eSpark-Consulting-Group/stephenlong-poddesign-hw/Design-Files/POD-Design-v1.1/Deliverables/BOM/Client_BOM_POD-Design-v1.1.xlsx

# | Item Type | Designator | Description | Footprint | Manufacturer Part Number | Manufacturer | Value | Quantity | Remarks
1 | Antenna | ANT1 | RF ANT 2.4GHZ CHIP SOLDER SMD | ANT-1206 | 2450AT18B100E | Johanson | - | 1
2 | Diodes | BR3 | BRIDGE RECT 1P 600V 1A 4MICRODIP | TSSOP-4(5.0x4.4) | MDB6S | ON Semiconductor / Fairchild | - | 1
3 | Capacitors | C1, C2, C3, C4, C5, C6, C7, C8, C11, C12, C13, C14 | CAP CER 0.022UF 50V C0G/NP0 0805 | Cap-0805 | GRM21B5C1H223JA01L | Murata | 22nF | 12
4 | Capacitor | C9, C10 | CAP CER 15PF 50V C0G/NPO 0603 | Cap-0603 | CC0603JRNPO9BN150 | Yageo | 15pF | 2
5 | Capacitors | C15, C16, C17, C18, C20, C22, C24, C110, C111 | CAP CER 0.1UF 50V X7R 0603 | Cap-0603 | GCJ188R71H104KA12D | Murata | 0.1uF | 9
6 | Capacitors | C19, C21, C23, C25 | CAP CER 4.7UF 10V X7R 0603 | Cap-0603 | GRM188Z71A475KE15D | Murata | 4.7uF | 4
7 | Capacitors | C26, C29, C32 | 51 pF ±1% 250V Ceramic Capacitor C0G, NP0 0603 (1608 Metric) | Cap-0603 | GQM1875C2E510FB12D | Murata | 51pF | 3
8 | Capacitors | C27, C28, C30, C31, C33, C34 | CAP CER 0.022UF 500V X7R 1206 | Cap-1206 | CC1206KKX7RBBB223 | Yageo | 22nF | 6
9 | Capacitor | C35, C38 | CAP CER 1UF 16V X5R 0402 | Cap-0402 | CC0402KRX5R7BB105 | Yageo | 1uF | 2
10 | Capacitor | C36 | CAP CER 0.047UF 50V X7R 0402 | Cap-0402 | CC0402KRX7R9BB473 | Yageo | 47nF | 1
11 | Capacitors | ~~C37, C44~~ | ~~CAP CER 0.1UF 16V X7R 0402~~ | ~~Cap-0402~~ | ~~CC0402KRX7R7BB104~~ | ~~Yageo~~ | ~~DNP~~ | ~~2~~ | ~~DO NOT PLACE~~
12 | Capacitors | C39, C43, C52, C53, C55, C60, C67, C69, C71 | CAP CER 0.1UF 16V X7R 0402 | Cap-0402 | CC0402KRX7R7BB104 | Yageo | 0.1uF | 9
13 | Capacitor | C40, C41 | CAP CER 6.8PF 50V C0G/NPO 0402 | Cap-0402 | CC0402CRNPO9BN6R8 | Yageo | 6.8pF | 2
14 | Capacitor | C42 | CAP CER 100PF 50V C0G/NPO 0402 | Cap-0402 | CC0402JRNPO9BN101 | Yageo | 100pF | 1
15 | Capacitor | C45 | CAP CER 2.2PF 50V C0G/NP0 0402 | Cap-0402 | GRM1555C1H2R2BA01D | Murata | 2.2pF | 1
16 | Capacitor | C46, C47 | 50V 9pF C0G 0402 Multilayer Ceramic Capacitors MLCC - SMD/SMT ROHS | Cap-0402 | 0402CG9R0C500NT | FH (Guangdong Fenghua Advanced Tech) | 9pF | 2
17 | Capacitor | C48 | CAP CER 0.8PF 50V C0G/NPO 0402 | Cap-0402 | CC0402BRNPO9BNR80 | Yageo | 0.8pF | 1
18 | Capacitor | C49 | CAP CER 820PF 50V C0G/NPO 0603 | Cap-0603 | CC0603JRNPO9BN821 | Yageo | 820pF | 1
19 | Capacitor | C50, C51, C54 | CAP CER 4.7UF 16V X5R 0402 | Cap-0402 | CL05A475MO5NUNC | Samsung | 4.7uF | 3
20 | Capacitor | C56 | CAP ALUM POLY 120UF 20% 20V SMD | Custom | 20SVPF120M | Panasonic | 120uF | 1
21 | Capacitor | C57, C58, C59, C61, C62, C70, C73 | CAP CER 10UF 10V X7R 0603 | Cap-0603 | GRM188Z71A106KA73D | Murata | 10uF | 7
22 | Capacitor | C63, C68 | CAP CER 0.1UF 16V X7R 0402 | Cap-0402 | CC0402JRX7R7BB104 | Yageo | 0.1uF | 2
23 | Capacitor | C64, C65 | CAP CER 22UF 10V X7R 0805 | Cap-0805 | GRM21BZ71A226ME15L | Murata | 22uF | 2
24 | Capacitors | C66 | CAP CER 1UF 6.3V X7R 0402 | Cap-0402 | GRM155R70J105KA12J | Murata | 1uF | 1
25 | Capacitor | C72 | 10uF 160V ±20% SMD,D8xL10.2mm Aluminum Electrolytic Capacitors - SMD ROHS | Custom | UD2C100M0810 | Honor Elec | 10uF | 1
26 | Capacitors | C74 | CAP CER 0.1UF 50V X7R 0603 | Cap-0603 | CC0603JRX7R9BB104 | Yageo | 0.1uF | 1
27 | Capacitor | C75, C77 | 50V 6.8nF X7R ±10% 0603 | Cap-0603 | 0603B682K500NT | FH | 6.8nF | 2
28 | Capacitor | C76 | CAP CER 0.015UF 50V X7R 0603 | Cap-0603 | CC0603JRX7R9BB153 | Yageo | 15nF | 1
29 | Capacitor | C78, C79 | CAP CER 1000PF 25V X7R 0402 | Cap-0402 | CC0402KRX7R8BB102 | Yageo | 1nF | 2
30 | Capacitor | C98 | CAP CER 1000PF 25V X7R 0603 | Cap-0603 |  |  | 1000pF | 1
31 | Capacitor | C99 | CAP CER 2200PF 50V X7R 0603 | Cap-0603 | CC0603KRX7R9BB222 | Yageo | 2.2nF | 1
32 | Capacitors | C100 | CAP CER 0.033UF 50V X7R 0603 | Cap-0603 | GCJ188R71H333KA12D | Murata | 33nF | 1
33 | Capacitor | C101 | CAP CER 0.1UF 50V X7R 0402 | cap-0402 | C1005X7R1H104KT000F | TDK | 100nF | 1
34 | Capacitors | C102 | CAP CER 0.033UF 25V X7R 0603 | Cap-0603 | CC0603JRX7R8BB333 | Yageo | 33nF | 1
35 | Capacitors | C103 | CAP CER 1UF 25V X7R 0603 | Cap-0603 | C1608X7R1E105K080AB | TDK | 1uF | 1
36 | Capacitors | C104 | CAP CER 2.2UF 50V X7R 0805 | Cap-0805 | CC0805KKX7R9BB225 | Yageo | 2.2uF | 1
37 | Diodes | D1, D2, D3, D4, D5, D6 | DIODE ARR GP 100V 215MA TO-236AB | SOT-23 | BAV99,215 | Nexperia | - | 6
38 | Diode | D7 | DIODE ZENER 3.3V 200MW SOD323F | SOD323F | MM3Z3V3B | ON Semiconductor / Fairchild | - | 1
39 | TVS Diodes | D8 | TVS DIODE 3VWM SOT323-5 | SOT-323-5 | ESDALC6V1W5 | STMicroelectronics | - | 1
40 | Diodes | D11, D16, D17, D18 | DIODE AVAL 600V 1.5A DO214AC | SMA(DO-214AC) | BYG20J-E3/TR | Vishay Semiconductors | - | 4
41 | Diode | D19 | Independent Type 2.5V~2.9V 500mW 2.7V LL-34 Zener Diodes ROHS | LL-34 | ZMM2V7 | HXY MOSFET | - | 1
42 | Ferrite Beads | FB1, FB2, FB3, FB4 | FERRITE BEAD 1.5 KOHM 0805 1LN | Ind-0805 | BLM21BD152SN1D | Murata | - | 4
43 | Ferrite Beads | FB5 | FERRITE BEAD 220 OHM 0805 1LN | Ind-0805 | BLM21PG221SN1D | Murata | - | 1
44 | Ferrite Bead | FB6 | FERRITE BEAD 1K OHM 0805 1LN | Ind-0805 | MMZ2012R102ATD25 | TDK | - | 1
45 | Ferrite Beads | FB7, FB8 | FERRITE BEAD 1 KOHM 0603 1LN | IND-0603 (1608 Metric) | BLM18HE102SN1D | Murata | - | 2
46 | USB Connector | J1 | 5A 1 16P Female Type-C SMD USB Connectors ROHS | Custom | TYPE-C-31-M-12 | Korean Hroparts Elec | - | 1
47 | Terminal Block | J2 | 320V 20A 14 Bend -40℃~+105℃ 1 5.08mm 1x14P Green Receptacle-Close Screw Fixing Push-Pull,P=5.08mm Pluggable System Terminal Block ROHS | Custom | DB2ERM-5.08-14P-GN | DORABO | - | 1
48 | Terminal Block | J3 | -40℃~+105℃ 2.5 1 14~28 5.08mm 320V 20A 14 1x14P Green Plug Screw Fixing P=5.08mm Pluggable System Terminal Block ROHS | Custom | DB2EKM-5.08-14P-GN-S | DORABO | - | 1
49 | Tag Connect | J4 | CABLE ADAPTER 6 POS | Custom | TC2030-IDC | Tag-Connect | - | 1
50 | Terminal Block | J5 | 320V 20A 4 Bend -40℃~+105℃ 1 5.08mm 1x4P Green Receptacle-Close Screw Fixing Push-Pull,P=5.08mm Pluggable System Terminal Block ROHS | Custom | DB2ERM-5.08-4P-GN | DORABO | - | 1
51 | Terminal Block | J6 | -40℃~+105℃ 2.5 1 14~28 5.08mm 320V 20A 4 1x4P Green Plug Screw Fixing P=5.08mm Pluggable System Terminal Block ROHS | Custom | DB2EKM-5.08-4P-GN-S | DORABO | - | 1
52 | Terminal Block | J7 | 1000V 57A 1 1 10.16mm P=10.16mm Pluggable System Terminal Block ROHS | Custom | DB136H-10.16-1P-RD-P | DORABO | - | 1
53 | Terminal Block | J8 | 1000V 57A 1 1 10.16mm P=10.16mm Pluggable System Terminal Block ROHS | Custom | DB136H-10.16-1P-BK-P | DORABO | - | 1
54 | Inductor | L1 | FIXED IND 15NH 400MA 0.45OHM SMD | IND-0402 | LQG15HN15NJ02D | Murata | 15nH | 1
55 | Inductors | L2 | FIXED IND 10UH 250MA 1.05OHM SMD | IND-0603 (1608 Metric) | MLZ1608M100WT000 | TDK | 10uH | 1
56 | Inductors | L3, L4 | FIXED IND 3.9NH 350MA 350MOHM SM | IND-0201 | LQP03TG3N9B02D | Murata | 3.9nH | 2
57 | Inductor | ~~L5~~ | ~~FIXED IND 2.7NH 500MA 200MOHM SM~~ | ~~IND-0201~~ | ~~LQP03TN2N7B02D~~ | ~~Murata~~ | ~~DNP~~ | ~~1~~ | ~~DO NOT PLACE~~
58 | Inductor | L6 | 2.34A 1.5uH Shielded Power Inductors ±20% SMD Power Inductors ROHS | Custom | LVT303012-1R5M-N | Chilisin Elec | 1.5uH | 1
59 | Inductor | L7 | 4A 2.2uH ±20% 32mΩ SMD,5.4x5.2x2mm Power Inductors ROHS | Custom | YSPI0520-2R2M | YJYCOIN | 2.2uH | 1
60 | LED | LED1, LED2, LED3, LED4, LED5 | Emerald 0603 Light Emitting Diodes (LED) ROHS | LED-0603 | NCD0603G2 | Foshan NationStar Optoelectronics | - | 5
61 | LED | LED6, LED7 | RED LED 0603 Light Emitting Diodes | LED-0603 | NCD0603R3 | Foshan NationStar Optoelectronics | - | 2
62 | Transistor | Q1 | TRANS NPN 40V 0.2A SOT523 | SOT-523 | MMBT3904T-7-F | Diodes Zetex | - | 1
63 | Triac | Q2 | 10mA 600V 1 TRIAC SOT-23-3L Thyristors (SCR)/Modules ROHS | SOT-23 | MAC97A6-23-3L | KY | - | 1
64 | SCRs | Q5, Q8 | SCR 800V 1.25A SOT223 | SOT- 223 | X0202NN 5BA4 | STMicroelectronics | - | 2
65 | BJTs | Q6 | TRANS NPN 400V 8A D2PAK | D2PAK | STB13007DT4 | STMicroelectronics | - | 1
66 | Resistor | R1, R5, R7, R8, R9, R13, R15, R19, R24, R25 | RES SMD 0R, 1%, 0.1W, 0603 | Res-0603 | RC0603FR-070RL | Yageo | 0R | 10
67 | Resistor | R2, R6, R10, R14, R16, R20 | RES SMD 1K OHM 1% 1/10W 0603 | Res-0603 | RC0603FR-071KL | Yageo | 1K | 6
68 | Resistors | R3, R4, R11, R12, R17, R18 | RES 0.002 OHM 1% 3W 2512 | RES-2512 | PA2512FKE7T0R002E | Yageo | 2mR | 6
69 | Resistor | R21, R22, R65, R66, R142, R143, R147 | RES 4.7K OHM 1% 1/16W 0402 | Res-0402 | RC0402FR-074K7L | Yageo | 4.7K | 7
70 | Resistor | R23 | RES SMD 10K Ohm 1% 1/10W 0603 | Res-0603 | RC0603FR-0710KL | Yageo | 10K | 1
71 | Resistor | R26, R27, R28, R29 | RES SMD 680 OHM 1% 1/10W 0603 | Res-0603 | RC0603FR-07680RL | Yageo | 680R | 4
72 | Resistors | R30, R31, R32, R33, R36, R37, R38, R39, R42, R43, R44, R45 | RES SMD 200K OHM 1% 1W 2512 | RES-2512 | CRCW2512200KFKEG | Vishay Dale | 200K | 12
73 | Resistor | R34, R35, R40, R41, R46, R47, R74 | RES 1K OHM 5% 1W 2512 | RES-2512 | RC2512JK-071KL | Yageo | 1K | 7
74 | Resistors | R48, R49, R50, R51, R52, R53, R54, R55, R56, R57, R58, R59, R60, R61, R62, R63, R64, R91, R92, R95, R152, R166, R167, R168, R169 | RES 0 OHM JUMPER 1/16W 0402 | Res-0402 | RC0402FR-070RL | Yageo | 0R | 25
75 | Resistor | R67, R76, R77, R78, R79, R80, R81, R82, R83, R89, R90, R157, R175 | RES 10K OHM 1% 1/16W 0402 | Res-0402 | RC0402FR-0710KL | Yageo | 10K | 13
76 | Resistor | R68 | RES 3.3K OHM 1% 1/16W 0402 | Res-0402 | RC0402FR-073K3L | Yageo | 3.3K | 1
77 | Resistor | R69, R73 | RES 1K OHM 1% 1/16W 0402 | Res-0402 | RC0402FR-071KL | Yageo | 1K | 2
78 | Resistor | ~~R70~~ | ~~RES SMD 100K OHM 0.1% 1/16W 0402~~ | ~~Res-0402~~ | ~~RT0402BRD07100KL~~ | ~~Yageo~~ | ~~DNP~~ | ~~1~~ | ~~DO NOT PLACE~~
79 | Resistor | R71, R72 | RES 5.1K OHM 1% 1/16W 0402 | Res-0402 | RC0402FR-075K1L | Yageo | 5.1K | 2
80 | Resistor | R75 | RES 680 OHM 1% 1/16W 0402 | Res-0402 | RC0402FR-07680RL | Yageo | 680R | 1
81 | Resistor | R84, R87, R134, R138 | RES 0 OHM JUMPER 1/8W 0805 | Res-0805 | RC0805FR-070RL | Yageo | 0R | 4
82 | Resistor | R85 | 3W ±1% 200kΩ 2512 Chip Resistor - Surface Mount ROHS | RES-2512 | HoCUH2512-3W-200KR-1% | Milliohm | 200K | 1
83 | Resistors | R86 | RES 6.2K OHM 5% 2W 2512 | RES-2512 | RC2512JK-7W6K2L | Yageo | 6.2K | 1
84 | Resistor | R88 | RES SMD 220 OHM 1% 1/10W 0603 | Res-0603 | RC0603FR-07220RL | Yageo | 220R | 1
85 | Resistor | R98, R161 | RES SMD 4.7K OHM 1% 1/10W 0603 | Res-0603 | RC0603FR-074K7L | Yageo | 4.7K | 2
86 | Resistors | R99, R100, R101 | RES 330 OHM 1% 1/4W 1206 | Res-1206 | RC1206FR-07330RL | Yageo | 330R | 3
87 | Resistor | R102, R144 | RES 0 OHM JUMPER 1W 2512 | RES-2512 | RC2512JK-070RL | Yageo | 0R | 2
88 | Resistor | R103, R104, R139, R140, R145, R146 | 1W Thick Film Resistor 200V ±100ppm/℃ ±1% 10kΩ 2512 Chip Resistor - Surface Mount ROHS | RES-2512 | FRC2512F1002TS | FOJAN | 10K | 6
89 | Resistor | ~~R132, R133, R135~~ | ~~RES 0 OHM JUMPER 1/8W 0805~~ | ~~Res-0805~~ | ~~RC0805FR-070RL~~ | ~~Yageo~~ | ~~DNP~~ | ~~3~~ | ~~DO NOT PLACE~~
90 | Resistor | R136 | 333mW Thin Film Resistor 200V ±0.5% ±10ppm/℃ 31.6kΩ 1206 Chip Resistor - Surface Mount ROHS | Res-1206 | TC0610D3162T5K | Uniroyal | 31.6K | 1
91 | Resistors | R137 | RES SMD 243 OHM 1% 1/4W 1206 | Res-1206 | AC1206FR-07243RL | Yageo Group | 243R | 1
92 | Resistor | R141, R173 | RES 3.3K OHM 0.5% 1/10W 0603 | Res-0603 | RC0603DR-073K3L | Yageo | 3.3K | 2
93 | Resistor | R148 | 1.5W Thick Film Resistors 400V ±100ppm/℃ ±5% 1MΩ 2010 Chip Resistor - Surface Mount ROHS | RES-2010 | AS101AJ0105T4E | UNI-ROYAL(Uniroyal Elec) | 1M | 1
94 | Resistor | R150 | RES 10K OHM 1% 1/10W 0603 | Res-0603 | RK73G1JTTD1002F | KOA Speer | 10K | 1
95 | Resistors | R158, R170, R171, R172 | RES 49.9K OHM 1% 1/4W 1206 | Res-1206 | RC1206FR-0749K9L | Yageo Group | 49.9K | 4
96 | Resistor | R162, R163, R164, R165 | RES 0 OHM JUMPER 1/10W 0603 | Res-0603 | RC0603JR-070RL | Yageo | 0R | 4
97 | Resistor | R174 | RES SMD 1K OHM 1% 1/10W 0603 | Res-0603 | CRCW06031K00FKEA | Vishay Dale | 1K | 1
98 | Resistors | R176, R178 | RES SMD 220K OHM 0.1% 1/4W 1206 | Res-1206 | RT1206BRD07220KL | Yageo | 220K | 2
99 | Resistor | R177 | 250mW Thick Film Resistors 200V ±100ppm/℃ ±1% 330Ω 1206 Chip Resistor - Surface Mount ROHS | Res-1206 | FRC1206F3300TS | FOJAN | 330R | 1
100 | Varistors | RV3 | 775V 385V 300V 470V Plugin Varistors ROHS | Custom | 471KD10J | Yageo | - | 1
101 | IC | U1 | IC AFE 7 CHAN 40LFCSP-WQ | 40-LFCSP-WQ (6x6) | ADE9000ACPZ | Analog Devices | - | 1
102 | IC | U2 | DGTL ISO 5000VRMS 4CH GP 16SOIC | SOIC-16-300mil | ISO7741DWR | Texas Instruments | - | 1
103 | IC | U3 | IC RF TXRX+MCU 802.15.4 73QFN | AQFN-73-EP(7x7) | NRF52840-QIAA-R | Nordic Semiconductor | - | 1
104 | IC | U4 | IC FLASH 128MBIT SPI/QUAD 8WSON | WSON-8-EP(6x8) | W25Q128JVEIQ | Winbond | - | 1
105 | IC | U5 | 1.6-V TO 5.5-V, 20-M, 4-A LOW IQ | SOT-583 | TPS2117DRLR | Texas Instruments | - | 1
106 | IC | U6 | IC REG BUCK BST 3.3V 900MA 10SON | 10-SON (2.5x2.5) | TPS63031DSKR | Texas Instruments | - | 1
107 | Power Module | U7 | Plugin Isolated Power Modules ROHS | Custom | B0303S-1WR2 | YLPTEC | - | 1
108 | (TVS/ESD) | U8 | 6A 12V 150W 6V Unidirectional 5V SOT-23-6 ESD and Surge Protection (TVS/ESD) ROHS | SOT-23-6 | USBLC6-2SC6 | TECH PUBLIC | - | 1
109 | IC | U9 | 4V~6V Polymer 1 3.5A SOP-8-EP Battery Management ICs ROHS | 8-SO-EP_ | SLM6600 | SOLA-IC | - | 1
110 | IC | U10 | IC BATT MON LI-ION 1CELL 8TDFN | 8-TDFN-EP (2x2) | MAX17048G+T10 | Maxim | - | 1
111 | IC | U11 | SHTC3 Series Digital ±2% RH SMT Humidity Temperature Sensor - DFN-8 | 4-WDFN Exposed Pad | SHTC3-TR-2.5KS | Sensirion | - | 1
112 | Accelerometers | U12 | ACCEL 2-16G I2C/SPI 14LGA | 14-LGA (3x5) | ADXL345BCCZ-RL7 | Analog Devices | - | 1
113 | IC | U13 | IC ADC 16BIT SIGMA-DELTA 10VSSOP | VSSOP-10 | ADS1115IDGSR | Texas Instruments | - | 1
114 | Current Sensors | U14 | POSITION&CURRENT SENSORS | TISON-8(8x8) | TLI4971-A120T5-U-E0001 | Infineon | - | 1
115 | IC | U15 | OPTOISOLATOR 4.17KV TRIAC 6SMD | SMD-6P | MOC3083SR2M | ON Semiconductor / Fairchild | - | 1
116 | Sensor and Detector Interfaces | U17 | IC SIGNAL PROCESSOR 14TSSOP | 14-TSSOP | NCS37020DTBR2G | onsemi | - | 1
117 | IC | U18 | DGTL ISO 5000VRMS 4CH GP 16SOIC | SOIC-16-300mil | ISO7740DWR | Texas Instruments | - | 1
118 | IC | U19, U20 | OPTOISOLATOR 5.3KV TRANS 4SMD | Custom | SFH6156-2 | Vishay | - | 2
119 | Crystal | X1 | 24.576MHz Surface Mount Crystal 12pF ±10ppm ±20ppm SMD3225-4P Crystals ROHS | SMD3225-4P | X322524576MOB4SI | YXC | 24.576MHz | 1
120 | Crystal | X2 | Crystal, 32.768KHZ, 6PF, 3.2MM X 1.5MM Rohs Compliant: Yes | SMD3215-2P | Q13FC13500049 | Epson | 32.768KHz | 1
121 | Crystal | X3 | CRYSTAL 32.0000MHZ 8PF SMD | SMD2016-4P | Q22FA12800025 | Epson | 32MHz | 1
