eSpark-Consulting-Group/stephenlong-poddesign-hw/Design-Files/POD-Design-v1.1/Deliverables/Supporting Files/POD-Design-v1.1.step

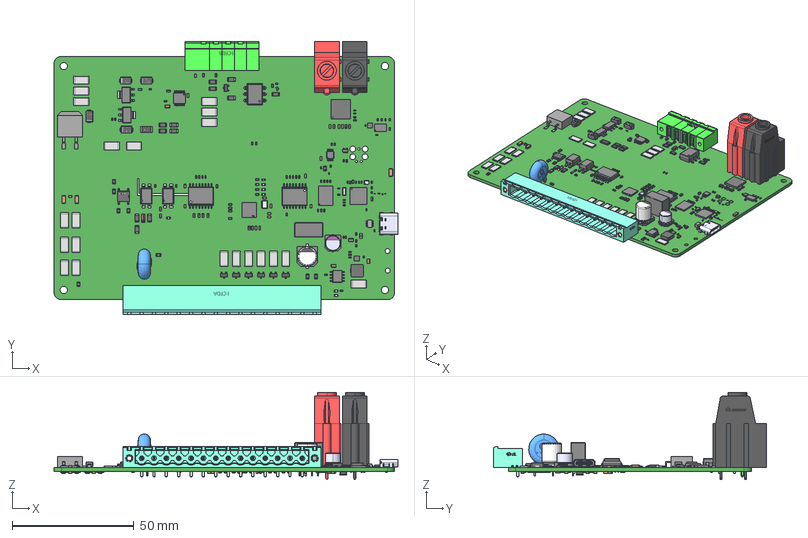
[picture p1: CAD file, 2025-09-22]
Design-Files/POD-Design-v1.1/Deliverables/Supporting Files/POD-Design-v1.1.step
141.4 x 112.3 x 35.8 mm
CircuitWorks-RESISTOR 2512 x 35
ISO1050DWR x 2
User Library-CR3216-1206 x 12
User Library-RES_1005-0402 x 52
User Library-RESC1608X05N x 32
User Library-LED SMD0603 x 7
Lötende x 6
base x 3
SMA (DO-214AC) x 4
User Library-CAPC1608X09 x 35
User Library-1206 SMD Capacitor x 7
User Library-SOT-223-1 x 2
TXB0104PWR
User Library-R_2010
User Library-CR2012-0805 x 7
pwr263s-35-8r20f_RGB6710886
CircuitWorks-SOT-23 x 7
User Library-SOT-523
User Library-0805 SMD Capacitor x 15
User Library-Capacitor 0402 x 30
MDB6S
DG136HT-10.16-01P-14-00A&Z(H)_RGB0
DG136HT-10.16-01P-14-00A&Z(H)_RGB255
User Library-NDK_NX3215SA
User Library-User Library-Siward_SX3225
LTC2634HMSE-LMI10#PBF
ADXL345BCCZ-RL7
SHTC3_SEN
21-0168E_T822-1_MXM
AP64501SP-13
21-0058I_MXM
TPS63031DSKR
W25Q128JVEIQ
2008102133_YJYCOIN-YSPI0520-2R2M_C718375
Ferrite x 3
User Library-d0402h025
TYPE-C-31-M-12
User Library-SOT-323-5L
User Library-SOD323F-1
20SVPF120M
