eSpark-Consulting-Group/stephenlong-poddesign-hw/(list of files, cad)

Other CAD files:
Design-Files/POD-Design-v1.1/Deliverables/Supporting Files/POD-Design-v1.1.DXF
