eSpark-Consulting-Group/stephenlong-poddesign-hw/Design-Files/POD-Design-v1.1/Ground-Fault-Detect-Sheet-3.pdf

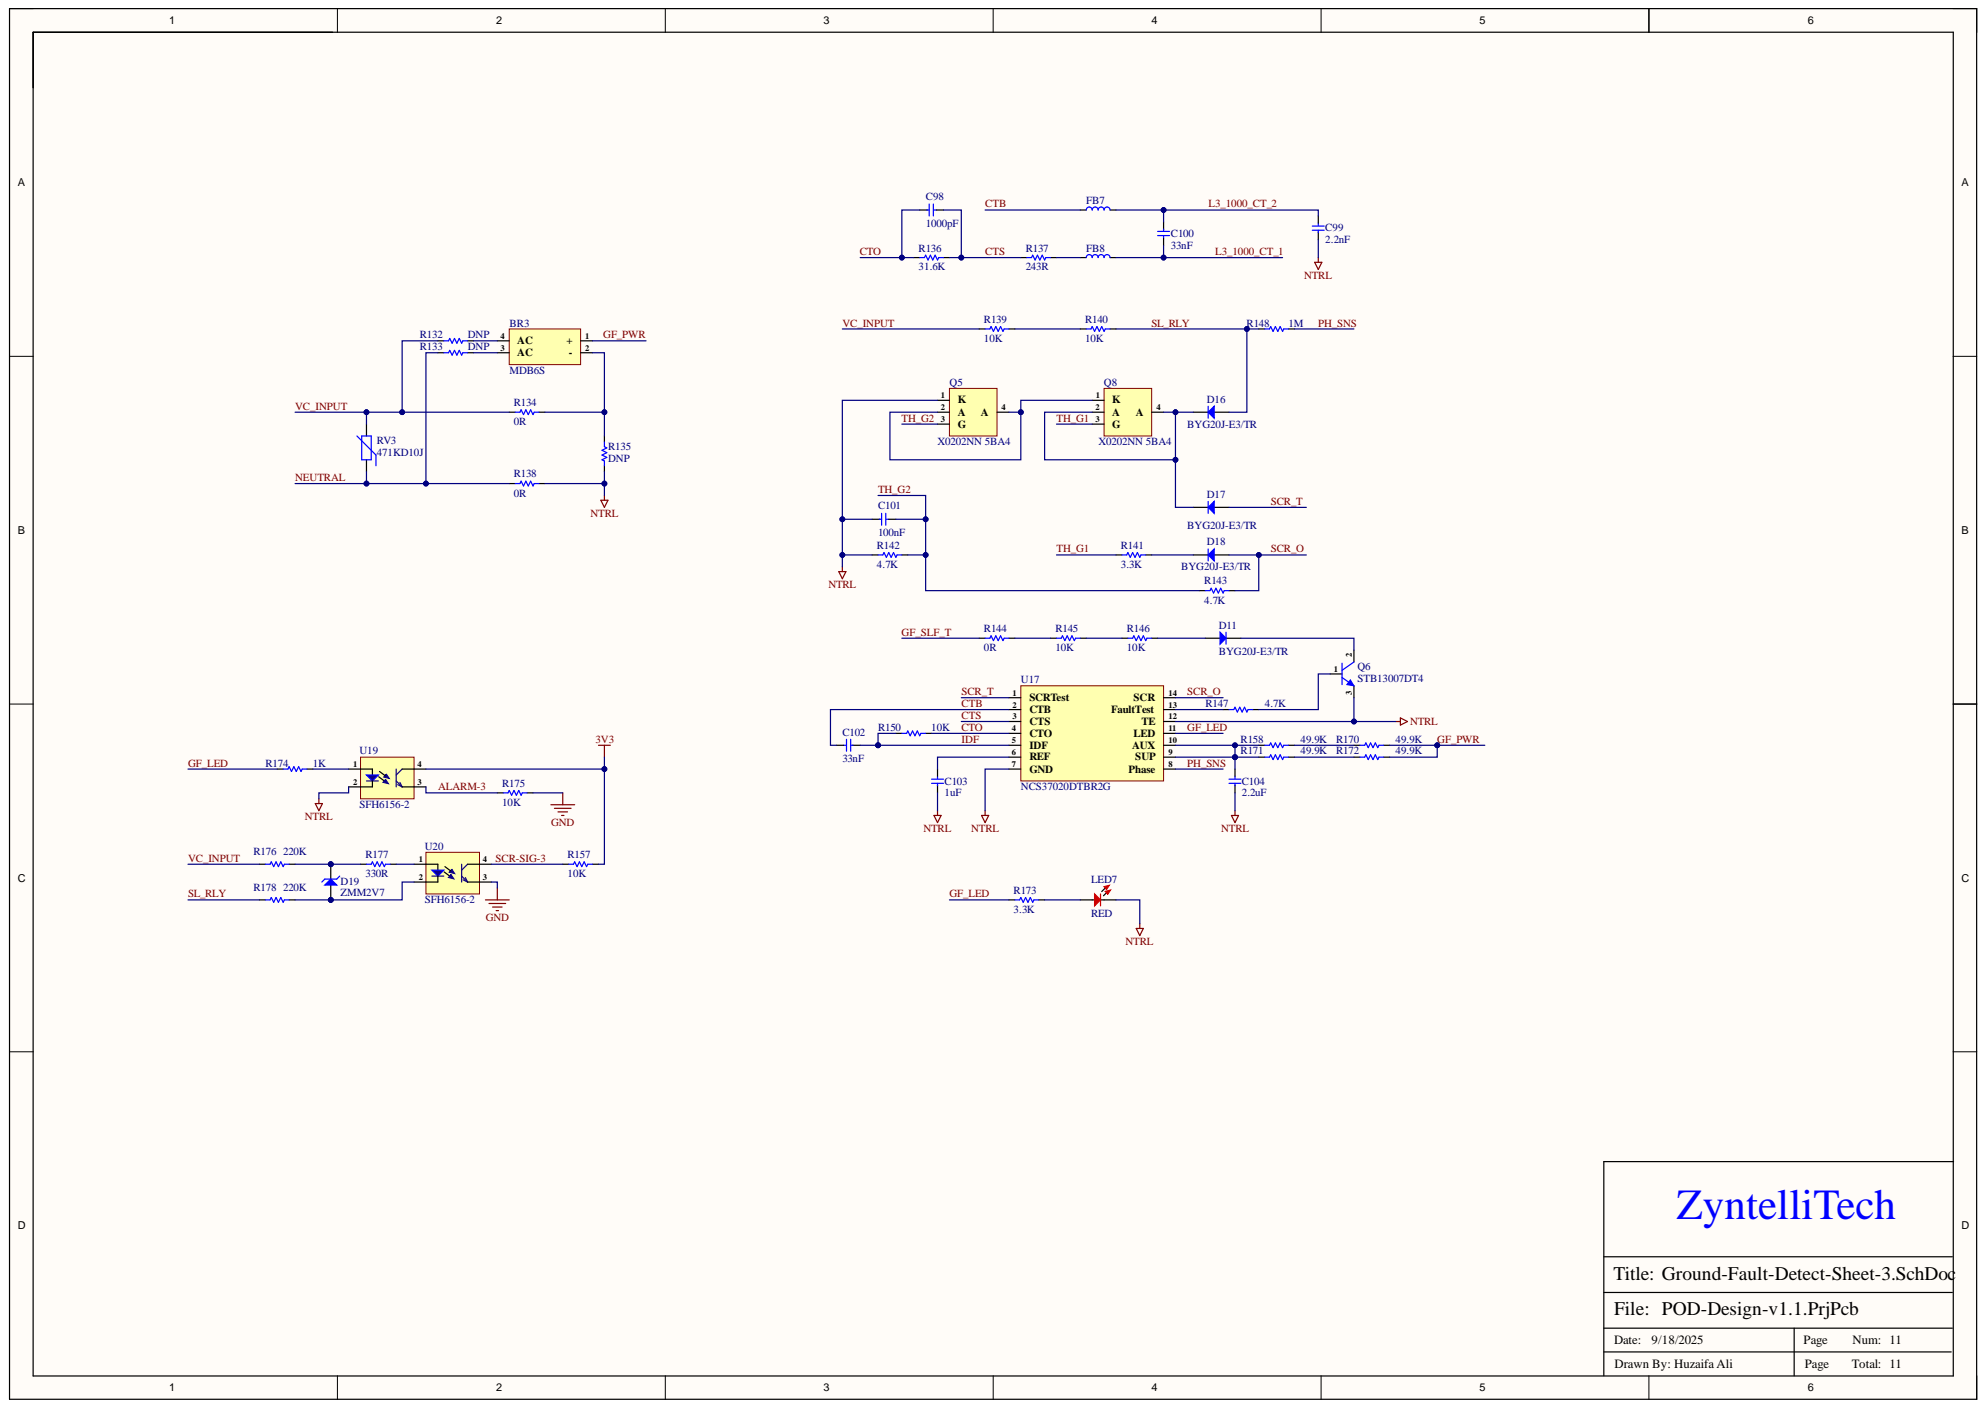
[picture p2: page 1]

Ground-Fault-Detect-Sheet-3.SchDoc

Date: 9/18/2025 | Page Num: 11

Drawn By: Huzaifa Ali | Page Total: 11
