eSpark-Consulting-Group/stephenlong-poddesign-hw/Design-Files/POD-Design-v1.1/Deliverables/Assembly Drawing/Assembly.pdf

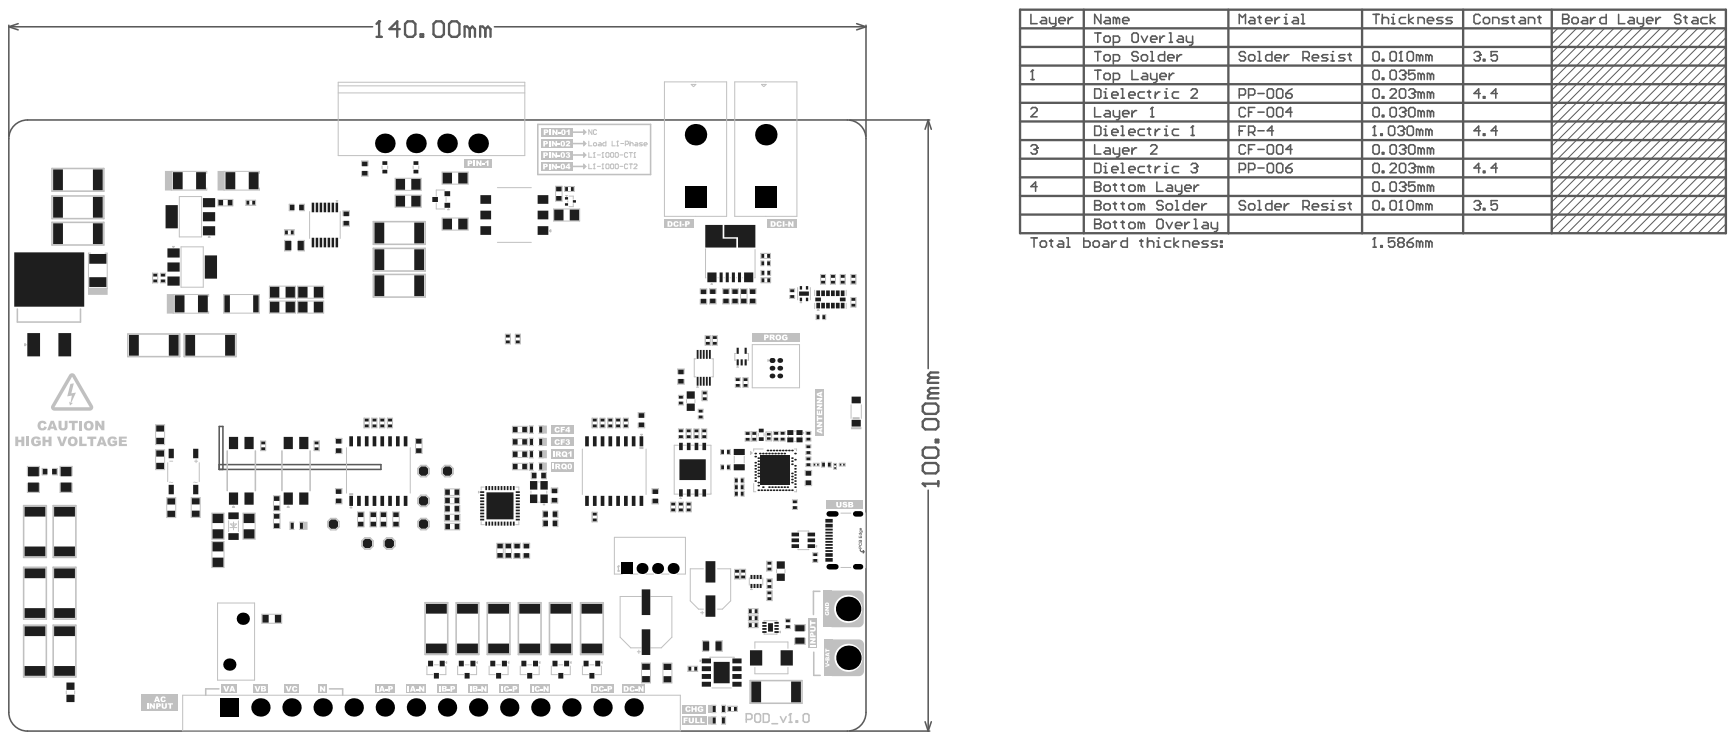
[picture p3: page 1]

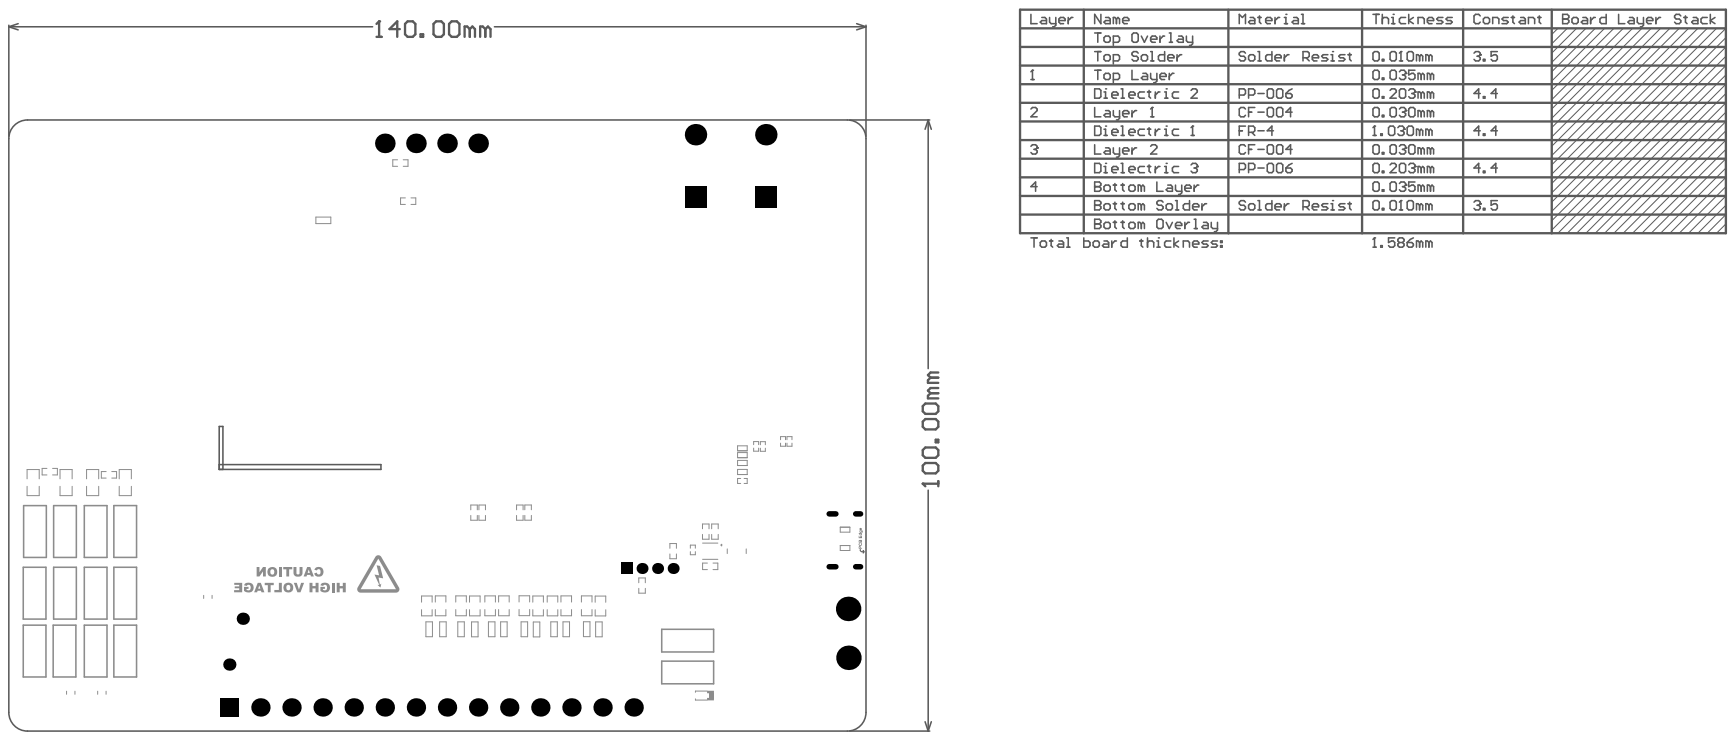
[picture p4: page 2]

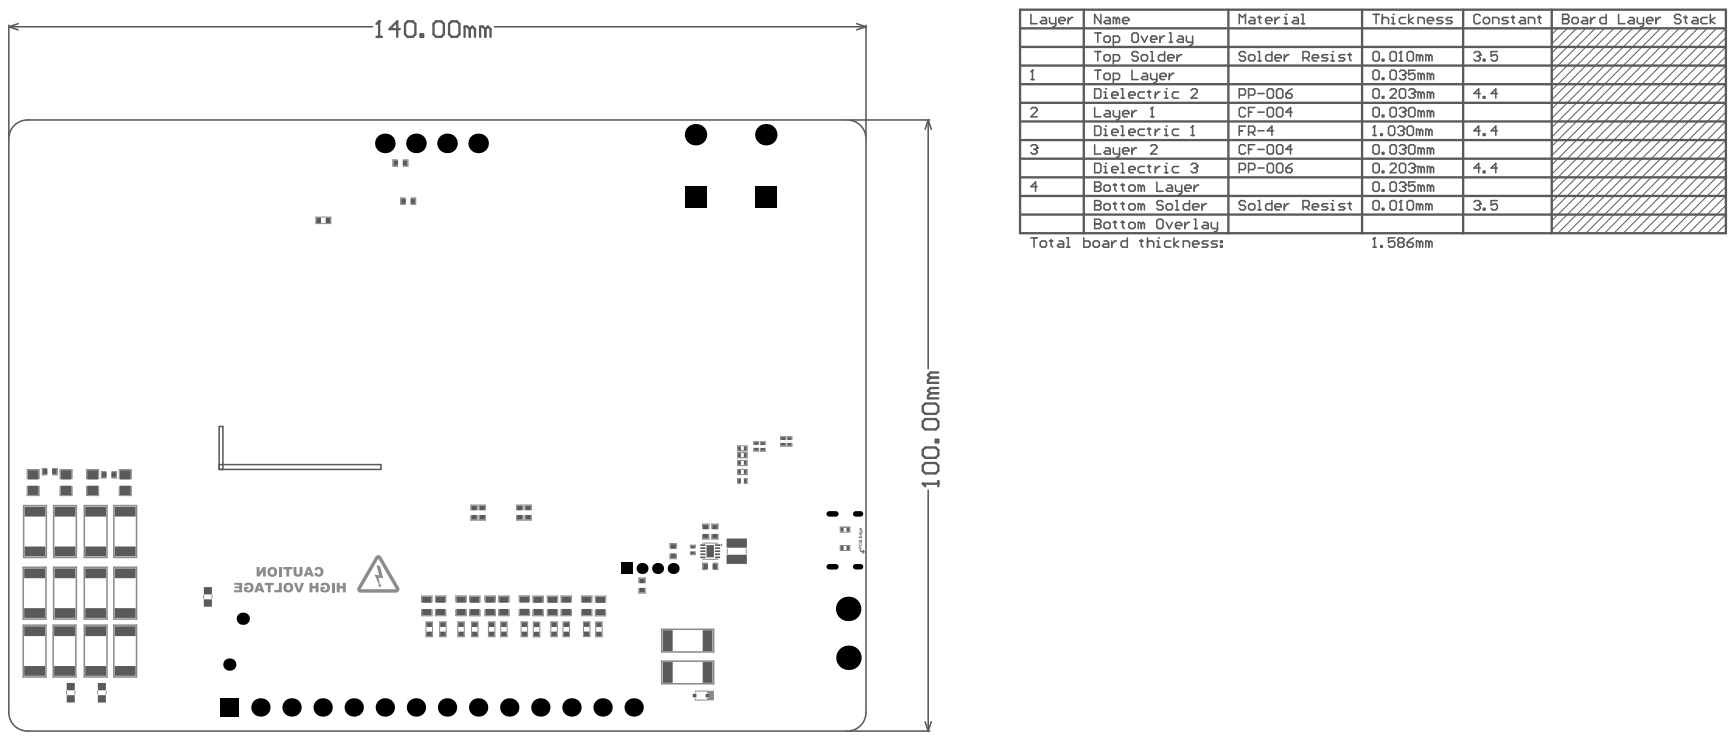
[picture p5: page 4]
