eSpark-Consulting-Group/stephenlong-poddesign-hw/(list of files, drawings)

Other design files:
Design-Files/POD-Design-v1.1/AC-Measurement-Sheet-1.SchDoc
Design-Files/POD-Design-v1.1/AC-Measurement-Sheet-2.SchDoc
Design-Files/POD-Design-v1.1/Battery-Charging-Sheet.SchDoc
Design-Files/POD-Design-v1.1/BLE-MCU-Sheet.SchDoc
Design-Files/POD-Design-v1.1/Connector-Sheet.SchDoc
Design-Files/POD-Design-v1.1/DC-Measurement-Sheet.SchDoc
Design-Files/POD-Design-v1.1/Ground-Fault-Detect-Sheet-3.SchDoc
Design-Files/POD-Design-v1.1/Motion-Temp-Sensor-Sheet.SchDoc
Design-Files/POD-Design-v1.1/POD-Design-v1.1.PcbDoc
Design-Files/POD-Design-v1.1/POD-Design-v1.1.PrjPcb
Design-Files/POD-Design-v1.1/Power-Sheet.SchDoc
