eSpark-Consulting-Group/stephenlong-poddesign-hw/(commit log)

2025-09-18 #2 Ground Fault section updated
    [AC-Measurement-Sheet-1.SchDoc, AC-Measurement-Sheet-2.SchDoc, BLE-MCU-Sheet.SchDoc, Battery-Charging-Sheet.SchDoc, Connector-Sheet.SchDoc, DC-Measurement-Sheet.SchDoc, Ground-Fault-Detect-Sheet-3.SchDoc, Motion-Temp-Sensor-Sheet.SchDoc]
2025-09-22 #4 Changes completed. Deliverables generated
    [Centroid.csv, POD-Design-v1.1.DXF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]
2025-09-22 #4 Overlay updated. Completed
    [POD-Design-v1.1.GBL, POD-Design-v1.1.GBO, POD-Design-v1.1.GBP, POD-Design-v1.1.GBS, POD-Design-v1.1.GKO, POD-Design-v1.1.GM1, POD-Design-v1.1.GTL, POD-Design-v1.1.GTO]
2025-09-23 Client and JLCPCB BOM Updated.
    [Client_BOM_POD-Design-v1.1.xlsx, JLCPCB_BOM_POD-Design-v1.1.xlsx]
